R0mba-Na11avan/425_Function_Generator/Function_Generator_PCB/.pcb_assistant/memory.md

- config.h still OUTPUT_PEAK 10 V / 12 Vpp; user earlier said limit 5 V in sw - unresolved.
- AD9833 ds p.3: VOUT 38 mV-0.65 V typ; p.12 current DAC into on-chip 200R, R4 load scales whole wave. R4=10k -> Vc 0.337, 0.600 Vpp.
- (2026-11-13) User ADOPTED gain-stage values: R6/R19 2.00k, R10/R22 3.00k, R9/R21 1.00k; R5/R18 replaced by divider 3.3V->100R(+10uF)->3.83k->IN-, 576R IN-->GND (0.422 V, Rth 502). Square R3/R16 39.2k, R4/R17 10k (sq high level unverified). LTspice confirmed DC null with Vc 0.337.
- Suggested firmware residual-DC comp per waveform instead of trimpot (not done).
- Open schematic bugs: U5.1/U5.6 (U12 same) shorted on 10V_ref net -> add Ra 4.02k. Summer R13=Ra=R12=4.02k, R11=2.00k. +10V and +0.3V nets undriven. No sine RC LPF yet. -12V/3.3V decoupling missing.
- (2026-11-14) (2026-11-13) User buffered refs on U15 (OPA2810): U15A follower CENTER_BIAS from R25(3.3V)/R26 -> advised 68.1k/10.0k (0.4225 V) + 1uF on IN+; R5/R18 now plain 499. U15B follower +10V from R27(+12V)/R28 -> advised 20.0k/100k (10.0 V) + 1uF. AD5452 ds missing; VREF ±10 V from parts.md only.
- (2026-11-14) (2026-11-13) AD5452 ds now in library: VREF range ±10 V (p.3), VREF/RFB abs max ±12 V (p.6), VREF Rin 7-11k (p.3) -> +10V ref OK. Decoupling p.24: 0.1uF ceramic || 10uF per device at VDD pin. p.17: 1-2 pF C1 across RFB (pin8 to IOUT pin1) for high-speed I/V amp (OPA2810) - advised.
- (2026-11-14) Summer Ra FIXED: R29 (U5.1->10V_ref CH1), R30 (U12.1->FG_CH2/10V_ref). Value 4.02k advised; footprints unset.
- (2026-11-14) Summer final: Ra/R12/R13 & R30/R14/R20 = 4.02k, R11/R15 = 2.00k, all 0603 (R11 50 mW; 1k would be 100 mW).
- (2026-11-14) (2026-11-14) Sch now has: C17-20 100n + C23-26 10u on +3.3V; C21/C22 1.5p RFB caps on U8/U13 only (U9/U14 offset DACs none); 12x10n op-amp decoupling (matches OPA2810 ds p.36). SW3 TS5A23157 is a breakout module, no decap needed. Missing: bulk 2.2-6.8uF on -12V, C1/C2 values, footprints.
