R0mba-Na11avan/425_Function_Generator/Function_Generator_PCB/LTSpice_Simulation/20x_gain_test.asc

R1: res; 499
R2: res; 1k
R3: res; 2k
R4: res; 3k
U1: opamp
U2: opamp
V1: voltage; SINE(0.337 0.3 1k)
V2: voltage; 0.43
Named nets: 0, V_out, V_in, v_inter
.tran 0 10m 0
.lib opamp.sub
