R0mba-Na11avan/425_Function_Generator/Function_Generator_PCB/FG_CH1.kicad_sch

## KiCad design Function_Generator_PCB/FG_CH1.kicad_sch (2026-11-14, an earlier design)

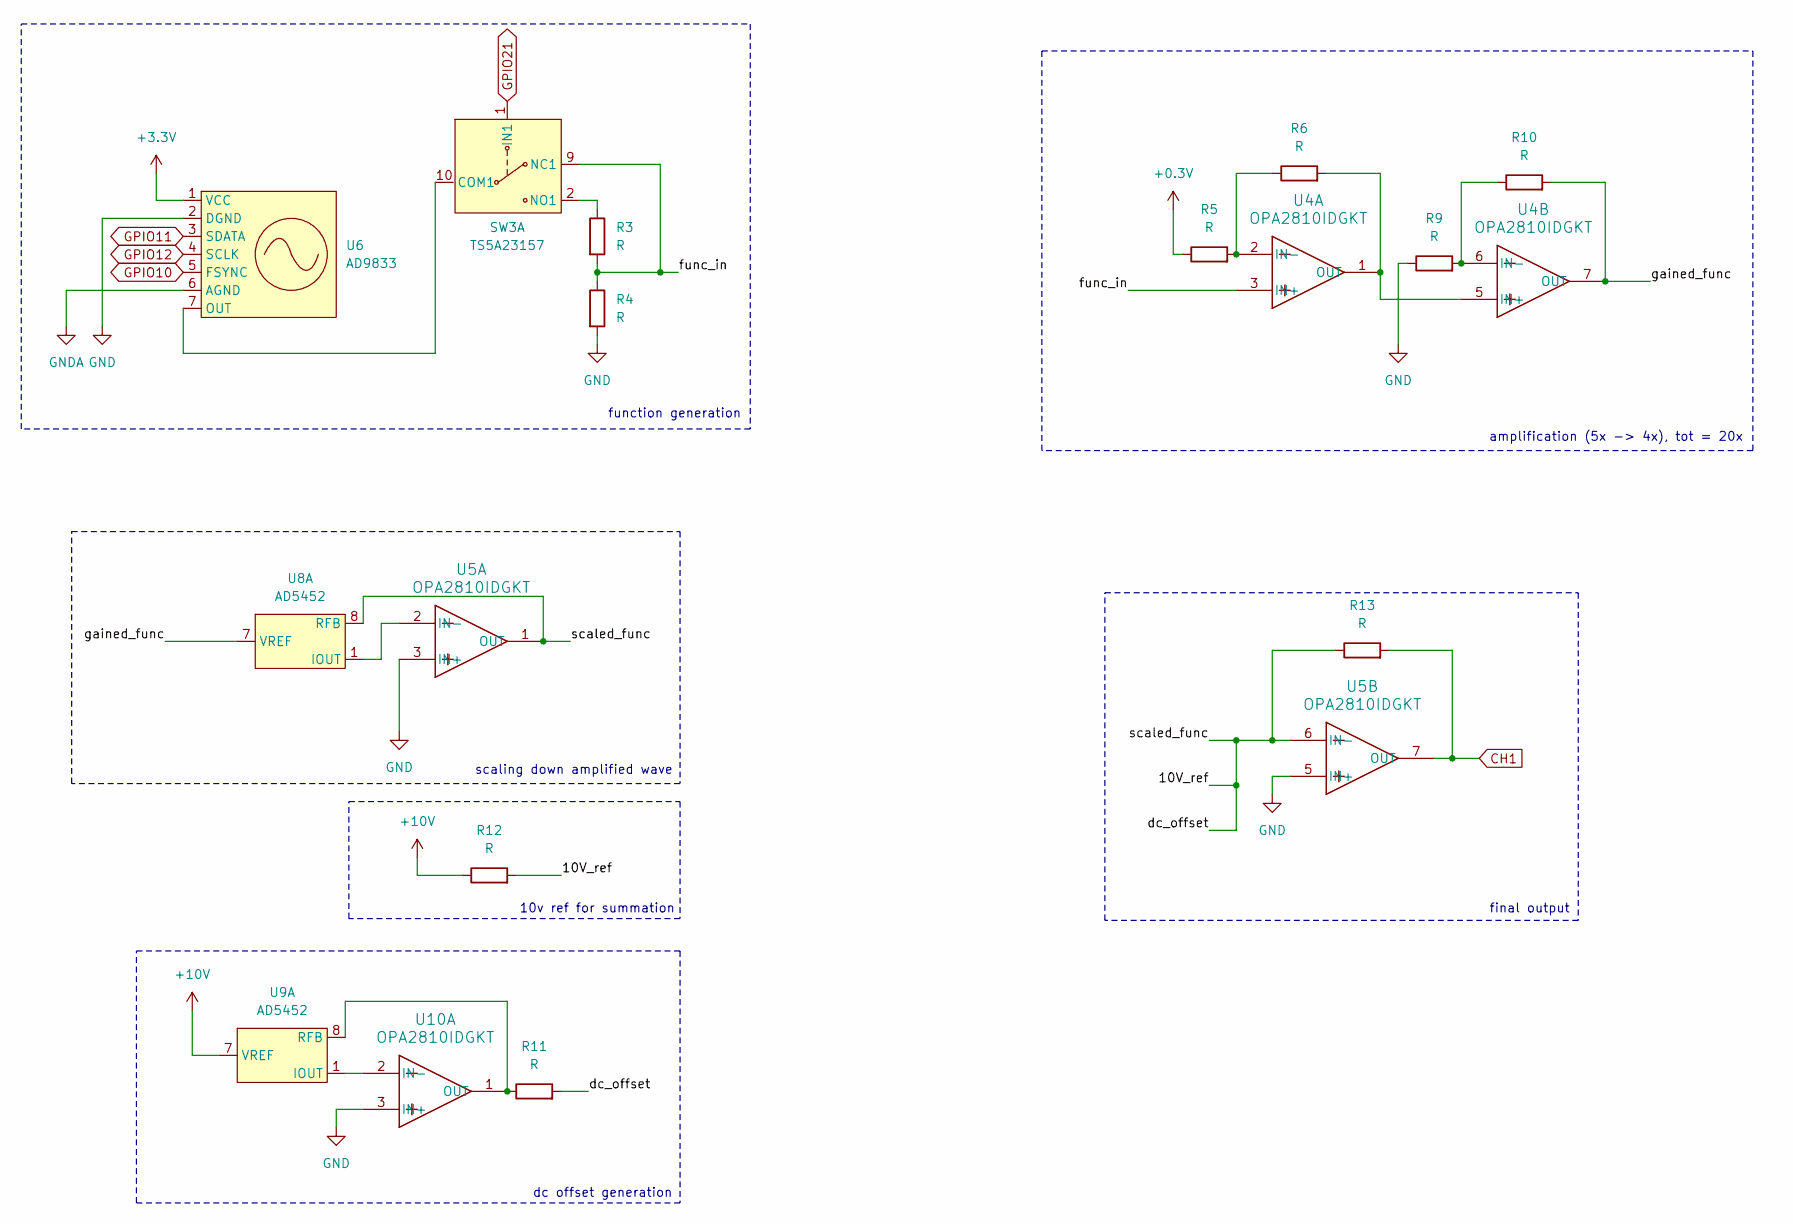
[picture p1: schematic FG_CH1.kicad_sch]

Parts:
R3, R4, R5, R6, R9, R10, R11, R12, R13: R
SW3: TS5A23157
U4, U5, U10: OPA2810IDGKT; DGK0008A_N
U6: AD9833
U8, U9: AD5452; RM_8_ADI-M

Connections:
10V_ref: R11.2, R12.2, R13.1, U5.1 (OUT), U5.6 (IN-), U8.8 (RFB)
+0.3V: R5.1
+3.3V: U6.1 (VCC)
+10V: R12.1, U9.7 (VREF)
CH1: R13.2, U5.7 (OUT)
GND: R4.2, R9.1, U5.3 (IN+), U5.5 (IN+), U6.2 (DGND), U10.3 (IN+)
GNDA: U6.6 (AGND)
GPIO10: U6.5 (FSYNC)
GPIO11: U6.3 (SDATA)
GPIO12: U6.4 (SCLK)
GPIO21: SW3.1 (IN1)
unnamed: R3.1, SW3.2 (NO1)
unnamed: R5.2, R6.1, U4.2 (IN-)
unnamed: R6.2, U4.1 (OUT), U4.5 (IN+)
unnamed: R9.2, R10.1, U4.6 (IN-)
unnamed: R11.1, U9.8 (RFB), U10.1 (OUT)
unnamed: SW3.10 (COM1), U6.7 (OUT)
unnamed: U5.2 (IN-), U8.1 (IOUT)
unnamed: U9.1 (IOUT), U10.2 (IN-)
func_in: R3.2, R4.1, SW3.9 (NC1), U4.3 (IN+)
gained_func: R10.2, U4.7 (OUT), U8.7 (VREF)

Notes on the sheet:
10v ref for summation
function generation
scaling down amplified wave
final output
amplification (5x -> 4x), tot = 20x
dc offset generation
