R0mba-Na11avan/425_Function_Generator/Function_Generator_PCB/FG_CH2.kicad_sch

## KiCad design Function_Generator_PCB/FG_CH2.kicad_sch (2026-11-14, an earlier design)

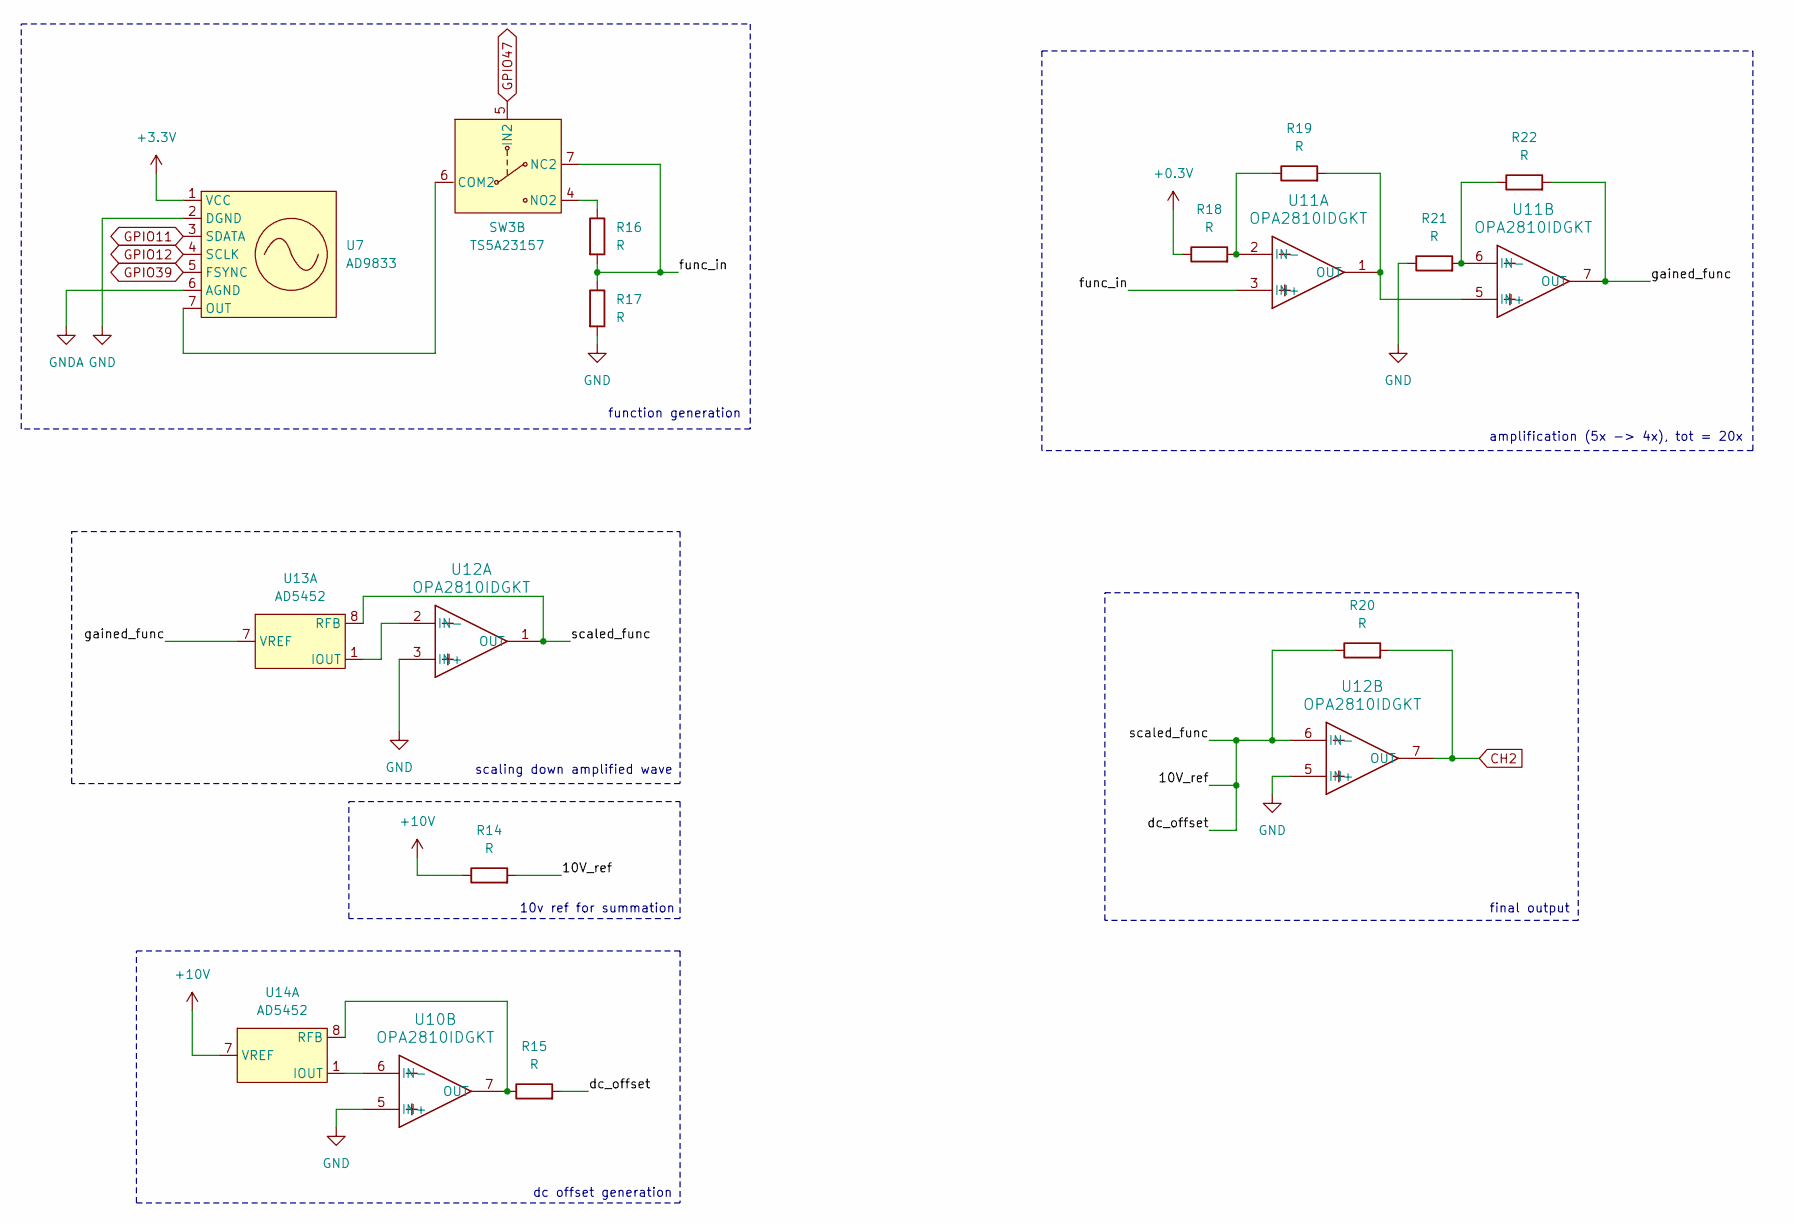
[picture p2: schematic FG_CH2.kicad_sch]

Parts:
R14, R15, R16, R17, R18, R19, R20, R21, R22: R
SW3: TS5A23157
U7: AD9833
U10, U11, U12: OPA2810IDGKT; DGK0008A_N
U13, U14: AD5452; RM_8_ADI-M

Connections:
10V_ref: R14.2, R15.2, R20.1, U12.1 (OUT), U12.6 (IN-), U13.8 (RFB)
+0.3V: R18.1
+3.3V: U7.1 (VCC)
+10V: R14.1, U14.7 (VREF)
CH2: R20.2, U12.7 (OUT)
GND: R17.2, R21.1, U7.2 (DGND), U10.5 (IN+), U12.3 (IN+), U12.5 (IN+)
GNDA: U7.6 (AGND)
GPIO11: U7.3 (SDATA)
GPIO12: U7.4 (SCLK)
GPIO39: U7.5 (FSYNC)
GPIO47: SW3.5 (IN2)
unnamed: R15.1, U10.7 (OUT), U14.8 (RFB)
unnamed: R16.1, SW3.4 (NO2)
unnamed: R18.2, R19.1, U11.2 (IN-)
unnamed: R19.2, U11.1 (OUT), U11.5 (IN+)
unnamed: R21.2, R22.1, U11.6 (IN-)
unnamed: SW3.6 (COM2), U7.7 (OUT)
unnamed: U10.6 (IN-), U14.1 (IOUT)
unnamed: U12.2 (IN-), U13.1 (IOUT)
func_in: R16.2, R17.1, SW3.7 (NC2), U11.3 (IN+)
gained_func: R22.2, U11.7 (OUT), U13.7 (VREF)

Notes on the sheet:
dc offset generation
10v ref for summation
amplification (5x -> 4x), tot = 20x
final output
function generation
scaling down amplified wave
