R0mba-Na11avan/425_Function_Generator/Function_Generator_PCB/Function-Generation.kicad_sch

## KiCad design Function_Generator_PCB/Function-Generation.kicad_sch (2026-11-14, an earlier design)

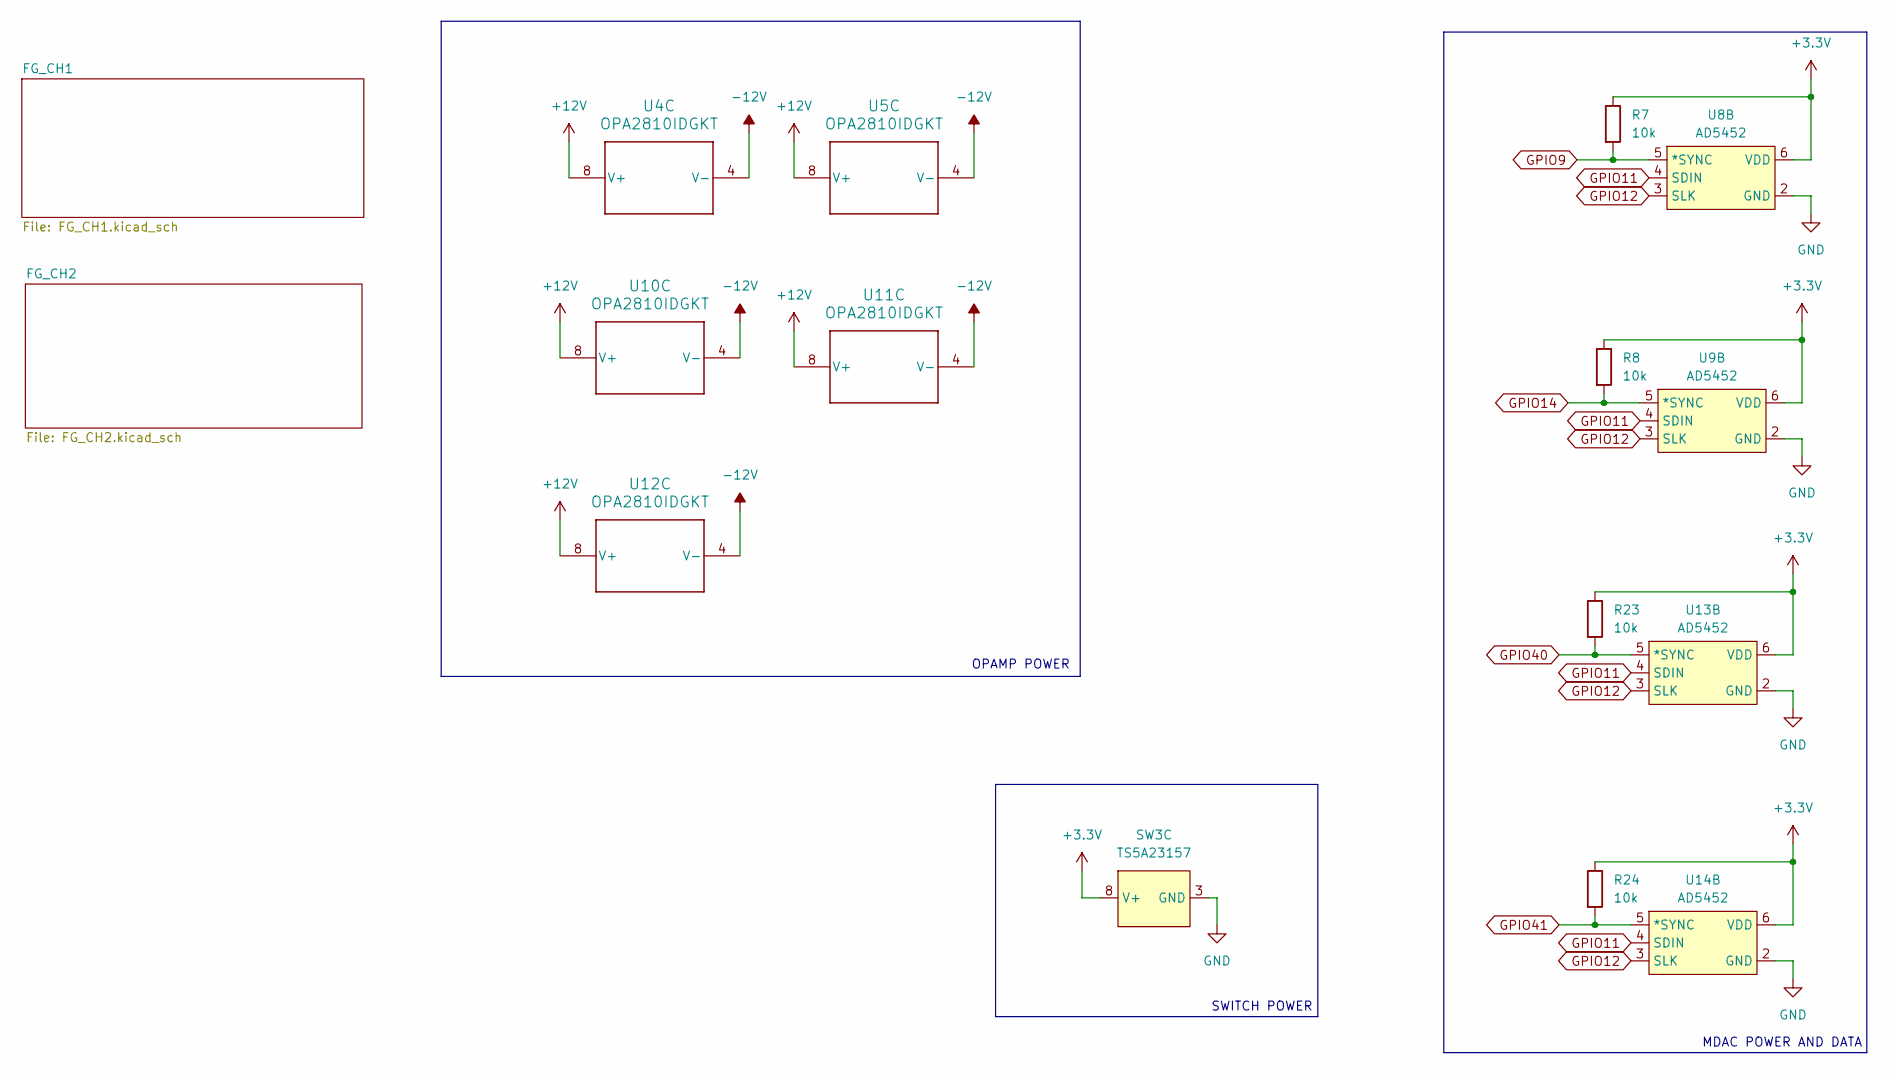
[picture p3: schematic Function-Generation.kicad_sch]

Parts:
R7, R8, R23, R24: 10k
SW3: TS5A23157
U4, U5, U10, U11, U12: OPA2810IDGKT; DGK0008A_N
U8, U9, U13, U14: AD5452; RM_8_ADI-M

Connections:
+3.3V: R7.1, R8.1, R23.1, R24.1, SW3.8 (V+), U8.6 (VDD), U9.6 (VDD), U13.6 (VDD), U14.6 (VDD)
+12V: U4.8 (V+), U5.8 (V+), U10.8 (V+), U11.8 (V+), U12.8 (V+)
-12V: U4.4 (V-), U5.4 (V-), U10.4 (V-), U11.4 (V-), U12.4 (V-)
GND: SW3.3 (GND), U8.2 (GND), U9.2 (GND), U13.2 (GND), U14.2 (GND)
GPIO9: R7.2, U8.5 (*SYNC)
GPIO11: U8.4 (SDIN), U9.4 (SDIN), U13.4 (SDIN), U14.4 (SDIN)
GPIO12: U8.3 (SLK), U9.3 (SLK), U13.3 (SLK), U14.3 (SLK)
GPIO14: R8.2, U9.5 (*SYNC)
GPIO40: R23.2, U13.5 (*SYNC)
GPIO41: R24.2, U14.5 (*SYNC)

Notes on the sheet:
OPAMP POWER
MDAC POWER AND DATA
SWITCH POWER
