R0mba-Na11avan/425_Function_Generator/Function_Generator_PCB/I-O.kicad_sch

## KiCad design Function_Generator_PCB/I-O.kicad_sch (2026-11-13, an earlier design)

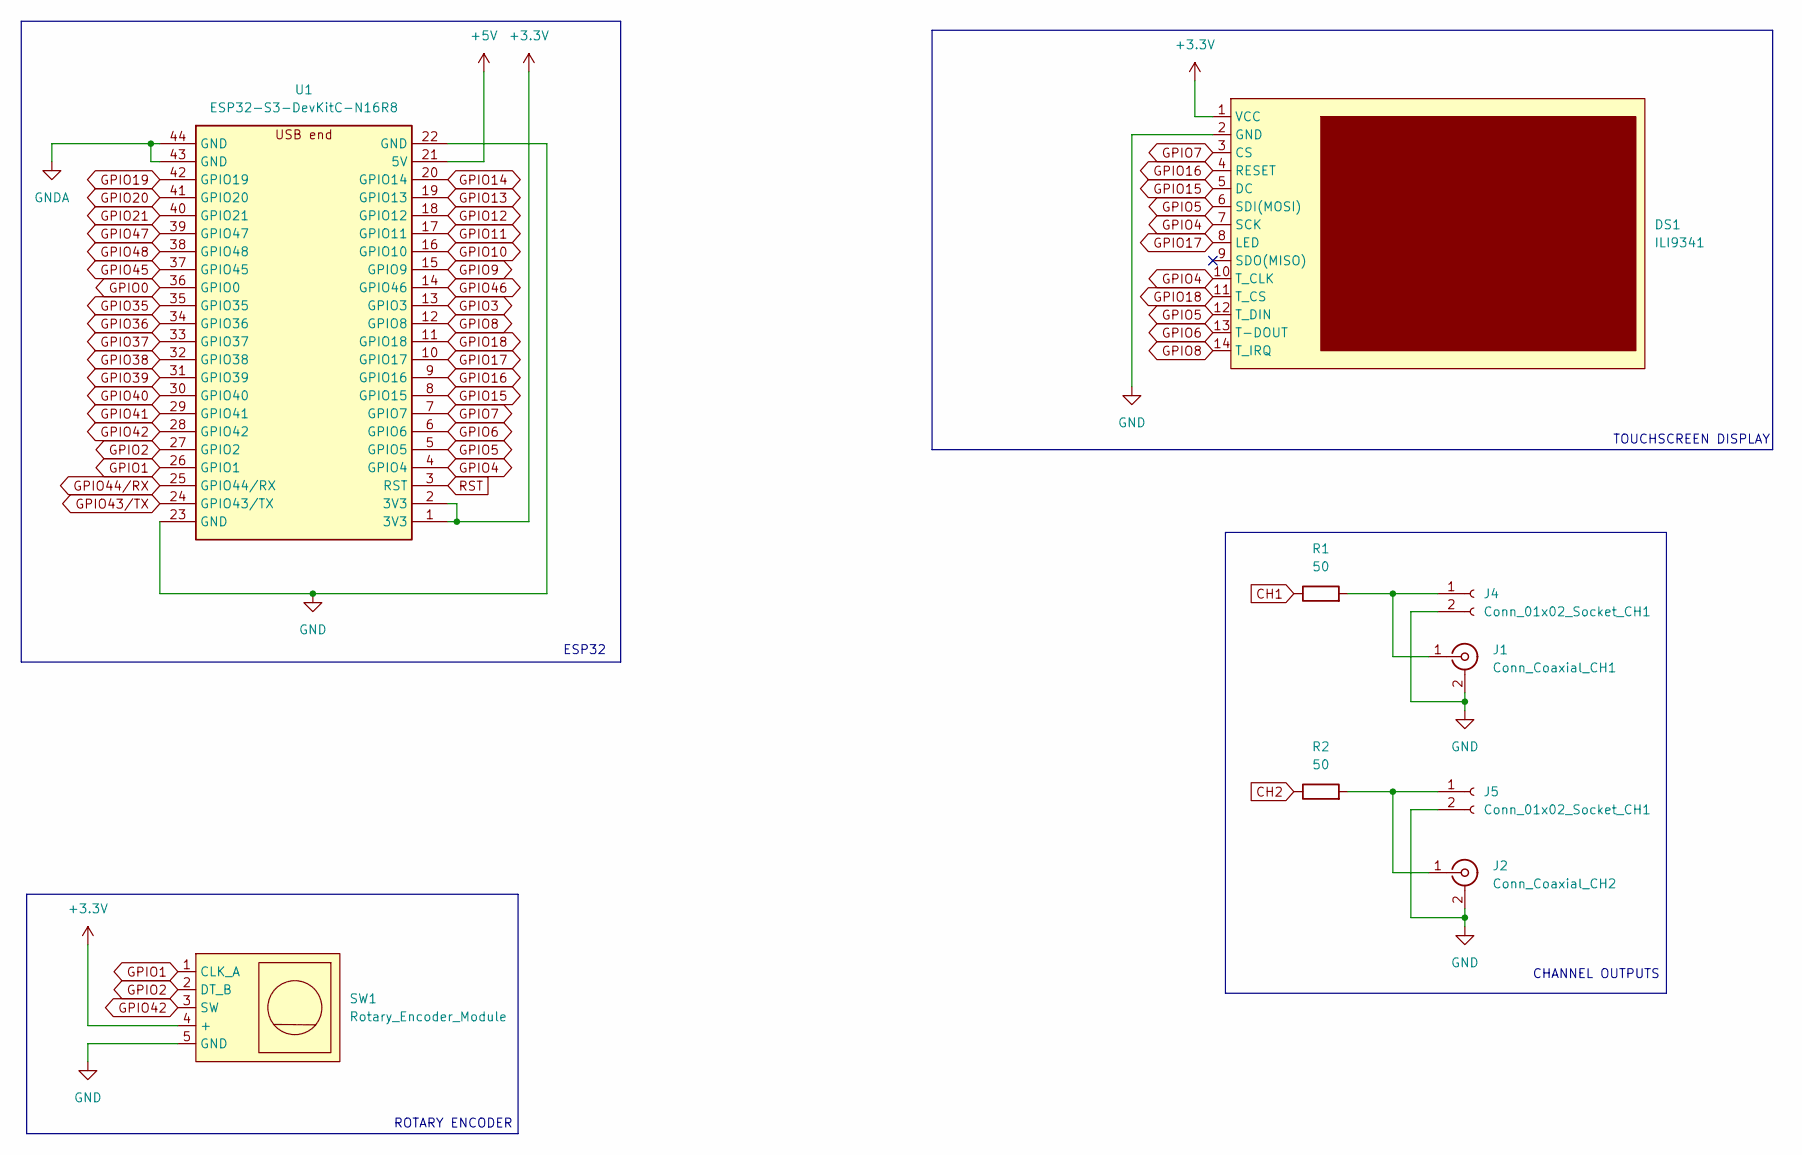
[picture p4: schematic I-O.kicad_sch]

Parts:
DS1: ILI9341
J1: Conn_Coaxial_CH1
J2: Conn_Coaxial_CH2
J4, J5: Conn_01x02_Socket_CH1
R1, R2: 50
SW1: Rotary_Encoder_Module; PinSocket_1x05_P2.54mm_Vertical
U1: ESP32-S3-DevKitC-N16R8; ESP32-S3-DevKitC-1_DualUSB

Connections:
+3.3V: DS1.1 (VCC), SW1.4 (+), U1.1 (3V3), U1.2 (3V3)
+5V: U1.21 (5V)
CH1: R1.1
CH2: R2.1
GND: DS1.2 (GND), J1.2 (Ext), J2.2 (Ext), J4.2, J5.2, SW1.5 (GND), U1.22 (GND), U1.23 (GND)
GNDA: U1.43 (GND), U1.44 (GND)
GPIO0: U1.36 (GPIO0)
GPIO1: SW1.1 (CLK_A), U1.26 (GPIO1)
GPIO2: SW1.2 (DT_B), U1.27 (GPIO2)
GPIO3: U1.13 (GPIO3)
GPIO4: DS1.7 (SCK), DS1.10 (T_CLK), U1.4 (GPIO4)
GPIO5: DS1.6 (SDI(MOSI)), DS1.12 (T_DIN), U1.5 (GPIO5)
GPIO6: DS1.13 (T-DOUT), U1.6 (GPIO6)
GPIO7: DS1.3 (CS), U1.7 (GPIO7)
GPIO8: DS1.14 (T_IRQ), U1.12 (GPIO8)
GPIO9: U1.15 (GPIO9)
GPIO10: U1.16 (GPIO10)
GPIO11: U1.17 (GPIO11)
GPIO12: U1.18 (GPIO12)
GPIO13: U1.19 (GPIO13)
GPIO14: U1.20 (GPIO14)
GPIO15: DS1.5 (DC), U1.8 (GPIO15)
GPIO16: DS1.4 (RESET), U1.9 (GPIO16)
GPIO17: DS1.8 (LED), U1.10 (GPIO17)
GPIO18: DS1.11 (T_CS), U1.11 (GPIO18)
GPIO19: U1.42 (GPIO19)
GPIO20: U1.41 (GPIO20)
GPIO21: U1.40 (GPIO21)
GPIO35: U1.35 (GPIO35)
GPIO36: U1.34 (GPIO36)
GPIO37: U1.33 (GPIO37)
GPIO38: U1.32 (GPIO38)
GPIO39: U1.31 (GPIO39)
GPIO40: U1.30 (GPIO40)
GPIO41: U1.29 (GPIO41)
GPIO42: SW1.3 (SW), U1.28 (GPIO42)
GPIO43/TX: U1.24 (GPIO43/TX)
GPIO44/RX: U1.25 (GPIO44/RX)
GPIO45: U1.37 (GPIO45)
GPIO46: U1.14 (GPIO46)
GPIO47: U1.39 (GPIO47)
GPIO48: U1.38 (GPIO48)
unnamed: J1.1 (In), J4.1, R1.2
unnamed: J2.1 (In), J5.1, R2.2
RST: U1.3 (RST)

Notes on the sheet:
CHANNEL OUTPUTS
ROTARY ENCODER
ESP32
TOUCHSCREEN DISPLAY
