R0mba-Na11avan/425_Function_Generator/Function_Generator_PCB/power.kicad_sch

## KiCad design Function_Generator_PCB/power.kicad_sch (2026-11-14, an earlier design)

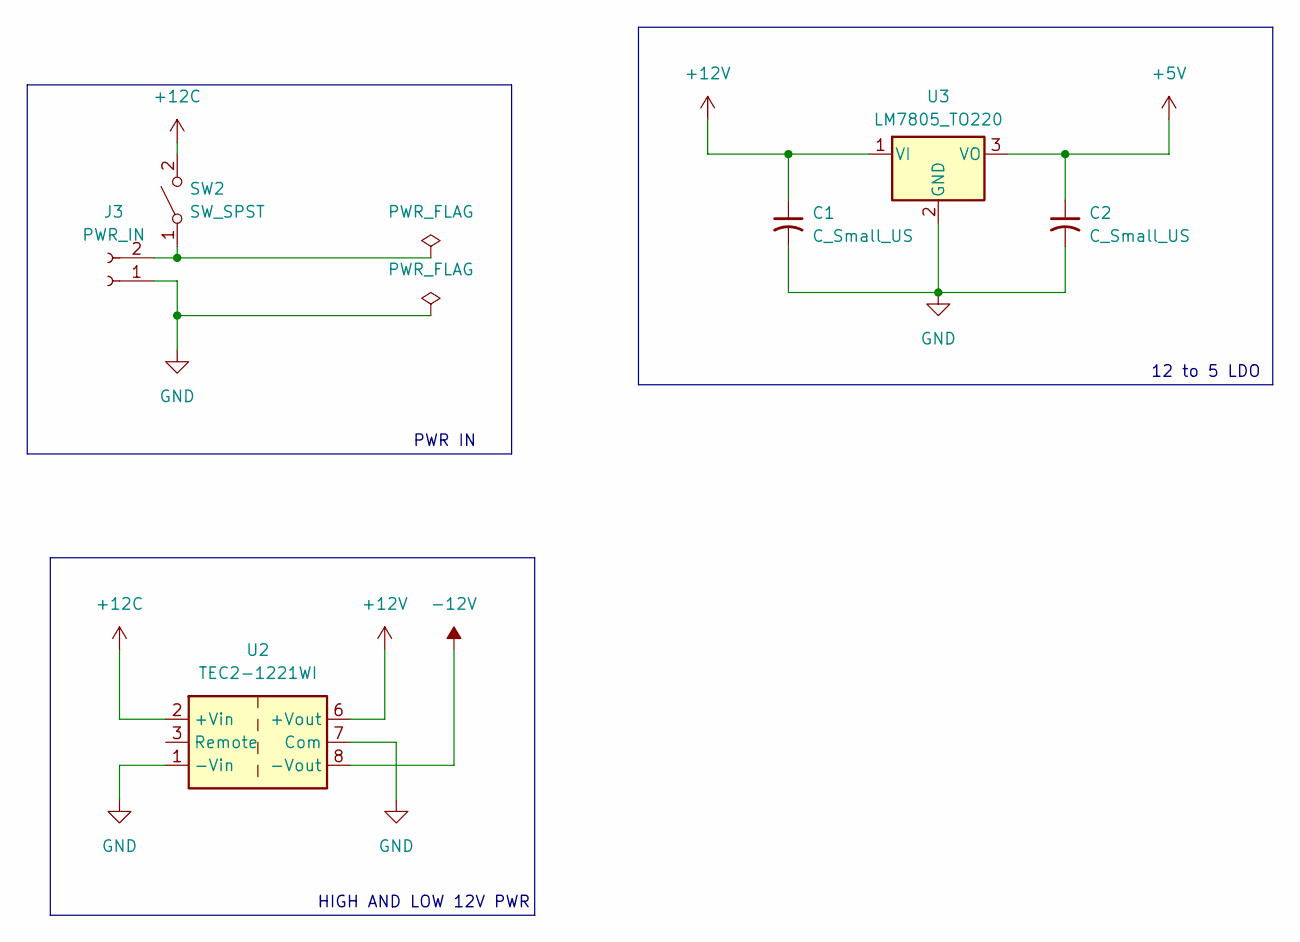
[picture p5: schematic power.kicad_sch]

Parts:
C1: C_Small_US; C_0805_2012Metric
C2: C_Small_US; CP_Radial_D6.3mm_P2.50mm
J3: PWR_IN; BarrelJack_CUI_PJ-102AH_Horizontal
SW2: SW_SPST; SW_PUSH-12mm_Wuerth-430476085716
U2: TEC2-1221WI; Converter_DCDC_TRACO_TEC2-12xxWI_24xxWI_48xxWI_THT
U3: LM7805_TO220; TO-220-3_Vertical

Connections:
+5V: C2.1, U3.3 (VO)
+12C: SW2.2 (B), U2.2 (+Vin)
+12V: C1.1, U2.6 (+Vout), U3.1 (VI)
-12V: U2.8 (-Vout)
GND: C1.2, C2.2, J3.1, U2.1 (-Vin), U2.7 (Com), U3.2 (GND)
unnamed: J3.2, SW2.1 (A)

Notes on the sheet:
12 to 5 LDO
PWR IN
HIGH AND LOW 12V PWR
