R0mba-Na11avan/425_Function_Generator/src/ui/dashboard_logic.cpp

#include "dashboard_logic.h"

#include <math.h>
#include <stdio.h>
#include <string.h>

//layout

static const Rect STATUS_RECT = {0, 0, LCD_WIDTH, 20};
static const Rect BLE_SLOT_RECT = {LCD_WIDTH - 20, 2, 16, 16};
static const Rect MCP_BADGE_RECT = {LCD_WIDTH - 56, 3, 32, 14};
static const Rect INFO_RECT = {0, 20, LCD_WIDTH, LCD_HEIGHT - 20};
static const Rect INFO_CLOSE_RECT = {LCD_WIDTH - 58, 24, 50, 18};
static const Rect INFO_BUTTON_RECTS[2] = {
    {10, 188, 145, 40},
    {165, 188, 145, 40}
};

static const Rect FIELD_RECTS[UI_FIELD_COUNT] = {
    {2, 22, 156, 70},       //WAVEFORM
    {162, 22, 156, 70},     //OUTPUT
    {2, 94, 316, 76},       //FREQUENCY
    {2, 172, 156, 66},      //AMPLITUDE
    {162, 172, 156, 66}     //OFFSET
};

//frequency field: unit column at the right, digits right aligned before it
static const int16_t FREQ_UNIT_W = 52;     //widest unit ("MHz") in FreeSansBold12
static const int16_t FREQ_MARGIN = 6;

Rect statusRect() {
    return STATUS_RECT;
}

Rect bleSlotRect() {
    return BLE_SLOT_RECT;
}

Rect mcpBadgeRect() {
    return MCP_BADGE_RECT;
}

Rect infoRect() {
    return INFO_RECT;
}

Rect infoCloseRect() {
    return INFO_CLOSE_RECT;
}

Rect infoButtonRect(uint8_t slot) {
    return INFO_BUTTON_RECTS[slot ? 1 : 0];
}

Rect fieldRect(UI_FIELD field) {
    return FIELD_RECTS[(uint8_t)field];
}

bool fieldAt(int16_t x, int16_t y, UI_FIELD& field) {
    for (uint8_t i = 0; i < UI_FIELD_COUNT; i++) {
        if (FIELD_RECTS[i].contains(x, y)) {
            field = (UI_FIELD)i;
            return true;
        }
    }
    return false;
}

//numbers

int16_t numCharWidth(char c) {
    //glyph widths of DigitalWF24pt7b (all digits share one cell, "1" sits at its right edge)
    if (c >= '0' && c <= '9') return 25;
    if (c == '.') return 4;
    if (c == '-') return 11;
    if (c == '+') return 12;
    return 25;
}

int16_t numTextWidth(const char* text) {
    int16_t w = 0;
    for (const char* p = text; *p; p++) {
        if (p != text) w += NUM_GAP;
        w += numCharWidth(*p);
    }
    return w;
}

int16_t numCharX(const char* text, int16_t startX, int8_t index) {
    int16_t cx = startX;
    for (int8_t i = 0; i < index && text[i]; i++) {
        cx += numCharWidth(text[i]) + NUM_GAP;
    }
    return cx;
}

int8_t numCharAt(const char* text, int16_t startX, int16_t x) {
    int16_t cx = startX;
    for (int8_t i = 0; text[i]; i++) {
        int16_t w = numCharWidth(text[i]);
        //each character owns half the gap on either side
        if (x >= cx - NUM_GAP / 2 && x < cx + w + NUM_GAP / 2) return i;
        cx += w + NUM_GAP;
    }
    return -1;
}

//frequency

FrequencyText formatFrequency(float hz) {
    FrequencyText f;
    //pick the unit from the rounded value so 999.96 Hz reads "1.000 kHz", not "1000.0 Hz"
    if (hz < 999.95f) {
        snprintf(f.text, sizeof(f.text), "%.1f", hz);
        f.unit = "Hz";
        f.unitScale = 1.0f;
    } else if (hz < 999999.95f) {
        //4 decimals, so the 0.1 Hz digit is on screen too
        snprintf(f.text, sizeof(f.text), "%.4f", hz / 1e3);
        f.unit = "kHz";
        f.unitScale = 1e3f;
    } else {
        snprintf(f.text, sizeof(f.text), "%.6f", hz / 1e6);
        f.unit = "MHz";
        f.unitScale = 1e6f;
    }
    return f;
}

int16_t freqUnitX() {
    return FIELD_RECTS[(uint8_t)UI_FIELD::FREQUENCY].w - FREQ_MARGIN - FREQ_UNIT_W;
}

int16_t freqTextStartX(const char* text) {
    return freqUnitX() - FREQ_MARGIN - numTextWidth(text);
}

float digitPlace(const char* text, int8_t index) {
    int len = (int)strlen(text);
    if (index < 0 || index >= len) return 0;
    if (text[index] < '0' || text[index] > '9') return 0;

    const char* dot = strchr(text, '.');
    int dotIndex = dot ? (int)(dot - text) : len;
    int power = (index < dotIndex) ? dotIndex - index - 1 : -(index - dotIndex);
    return powf(10.0f, (float)power);
}

int8_t stepDigitIndex(const FrequencyText& f, float stepHz) {
    for (int8_t i = 0; f.text[i]; i++) {
        float place = digitPlace(f.text, i) * f.unitScale;
        if (place > 0 && fabsf(place - stepHz) < stepHz * 0.01f) return i;
    }
    return -1;
}

float freqStepHz(uint8_t index) {
    static const float STEPS[FREQ_STEP_COUNT] = {0.1f, 1.0f, 10.0f, 100.0f, 1e3f, 1e4f, 1e5f, 1e6f};
    if (index >= FREQ_STEP_COUNT) index = FREQ_STEP_COUNT - 1;
    return STEPS[index];
}

float freqResolutionHz(float hz) {
    //same unit choice as formatFrequency: MHz shows 6 decimals (1 Hz), the rest 0.1 Hz
    return formatFrequency(hz).unitScale >= 1e6f ? 1.0f : 0.1f;
}

uint8_t freqStepShown(float hz, uint8_t index) {
    if (index >= FREQ_STEP_COUNT) index = FREQ_STEP_COUNT - 1;
    float res = freqResolutionHz(hz);
    while (index < FREQ_STEP_COUNT - 1 && freqStepHz(index) < res * 0.5f) index++;
    return index;
}

uint8_t nextFreqStep(float hz, uint8_t index) {
    uint8_t next = freqStepShown(hz, index) + 1;
    if (next >= FREQ_STEP_COUNT) next = 0;
    return freqStepShown(hz, next);
}

void formatFreqStep(uint8_t index, char* out, size_t len) {
    static const char* const LABELS[FREQ_STEP_COUNT] = {
        "0.1 Hz", "1 Hz", "10 Hz", "100 Hz", "1 kHz", "10 kHz", "100 kHz", "1 MHz"
    };
    if (index >= FREQ_STEP_COUNT) index = FREQ_STEP_COUNT - 1;
    snprintf(out, len, "%s", LABELS[index]);
}

//other readouts

void formatAmplitude(float vpp, char* out, size_t len) {
    snprintf(out, len, "%.2f", vpp);
}

void formatOffset(float volts, char* out, size_t len) {
    //avoid "-0.00" for tiny negative values
    if (fabsf(volts) < 0.005f) volts = 0.0f;
    snprintf(out, len, "%+.2f", volts);
}

const char* waveformName(WAVEFORM waveform) {
    switch (waveform) {
        case WAVEFORM::SINE: return "SINE";
        case WAVEFORM::SQUARE: return "SQUARE";
        case WAVEFORM::TRIANGLE: return "TRIANGLE";
        default: return "?";
    }
}

void formatNetLine(const NetStatus& net, char* out, size_t len) {
    switch (net.state) {
        case WIFI_STATE::CONNECTING:
            snprintf(out, len, "Connecting to %s...", net.ssid);
            break;
        case WIFI_STATE::CONNECTED:
            snprintf(out, len, "%s.local  %s", net.hostname, net.ip);
            break;
        case WIFI_STATE::AP_MODE:
            snprintf(out, len, "Setup: join %s  %s", net.ssid, net.ip);
            break;
        case WIFI_STATE::IDLE:
        default:
            snprintf(out, len, "Wi-Fi off");
            break;
    }
}

uint8_t formatInfoLines(const NetStatus& net, const BleStatus& ble, char lines[][INFO_LINE_LEN], uint8_t maxLines) {
    uint8_t n = 0;
    #define INFO_LINE(...) do { if (n < maxLines) snprintf(lines[n++], INFO_LINE_LEN, __VA_ARGS__); } while (0)

    switch (net.state) {
        case WIFI_STATE::CONNECTED:
            INFO_LINE("Connected to %s", net.ssid);
            INFO_LINE("IP address  %s", net.ip);
            INFO_LINE("MCP  http://%s.local/mcp", net.hostname);
            INFO_LINE("     http://%s/mcp", net.ip);
            break;
        case WIFI_STATE::CONNECTING:
            INFO_LINE("Connecting to %s...", net.ssid);
            INFO_LINE("Goes to setup mode if it can't join.");
            break;
        case WIFI_STATE::AP_MODE:
            INFO_LINE("Setup mode");
            INFO_LINE("1. Join the Wi-Fi %s", net.ssid);
            INFO_LINE("2. Open http://%s", net.ip);
            INFO_LINE("3. Pick your network and save");
            break;
        case WIFI_STATE::IDLE:
        default:
            INFO_LINE("Wi-Fi off");
            break;
    }
    if (ble.state == BLE_STATE::OFF) {
        INFO_LINE("Bluetooth off");
    } else {
        INFO_LINE("Bluetooth  %s", ble.name);
        INFO_LINE("Phones  %u connected, %u paired", ble.connected, ble.bonded);
    }
    INFO_LINE("Firmware %s", FIRMWARE_VERSION);
    #undef INFO_LINE
    return n;
}

InfoButtons infoButtons(const NetStatus& net, const BleStatus& ble) {
    InfoButtons b;
    if (net.state == WIFI_STATE::AP_MODE) b.wifi = net.savedSsid[0] ? WIFI_BUTTON::BACK_TO_SAVED : WIFI_BUTTON::NONE;
    else b.wifi = WIFI_BUTTON::CHANGE_NETWORK;
    b.phones = ble.state != BLE_STATE::OFF;
    return b;
}

void formatWifiButton(const NetStatus& net, WIFI_BUTTON button, char* out, size_t len) {
    //a long name is cut to the button's width when it is drawn (fitButtonLabel)
    switch (button) {
        case WIFI_BUTTON::CHANGE_NETWORK:
            snprintf(out, len, "Change Wi-Fi");
            break;
        case WIFI_BUTTON::BACK_TO_SAVED:
            snprintf(out, len, "Back to %s", net.savedSsid);
            break;
        case WIFI_BUTTON::NONE:
        default:
            if (len) out[0] = '\0';
            break;
    }
}

uint8_t changedFields(const FuncGenState& a, const FuncGenState& b) {
    uint8_t mask = 0;
    if (a.waveform != b.waveform) mask |= fieldBit(UI_FIELD::WAVEFORM);
    if (a.outputEnabled != b.outputEnabled) mask |= fieldBit(UI_FIELD::OUTPUT_ENABLE);
    if (a.frequency != b.frequency) mask |= fieldBit(UI_FIELD::FREQUENCY);
    if (a.amplitude != b.amplitude) mask |= fieldBit(UI_FIELD::AMPLITUDE);
    if (a.dcOffset != b.dcOffset) mask |= fieldBit(UI_FIELD::OFFSET);
    return mask;
}

//remote highlight

const char* remoteBadgeText(CHANGE_SOURCE source) {
    switch (source) {
        case CHANGE_SOURCE::BLE: return "BLE";
        case CHANGE_SOURCE::WEB: return "WEB";
        case CHANGE_SOURCE::MCP:
        default: return "MCP";
    }
}

void RemoteHighlight::changed(uint8_t fields, uint32_t nowMs, CHANGE_SOURCE source) {
    for (uint8_t i = 0; i < UI_FIELD_COUNT; i++) {
        if (fields & (1u << i)) _fieldAt[i] = nowMs;
    }
    _fields |= fields;
    _badgeAt = nowMs;
    _badge = true;
    _badgeSource = source;
}

uint8_t RemoteHighlight::flashing(uint32_t nowMs) const {
    uint8_t mask = 0;
    for (uint8_t i = 0; i < UI_FIELD_COUNT; i++) {
        if ((_fields & (1u << i)) && nowMs - _fieldAt[i] < UI_REMOTE_FLASH_MS) mask |= (uint8_t)(1u << i);
    }
    return mask;
}

bool RemoteHighlight::badge(uint32_t nowMs) const {
    return _badge && nowMs - _badgeAt < UI_REMOTE_BADGE_MS;
}

//pairing popup

void PairingPrompt::update(const BleStatus& ble, uint32_t nowMs) {
    if (ble.pairing == PAIRING::SHOW_PASSKEY && ble.pairingId != _id) {
        _id = ble.pairingId;
        _passkey = ble.passkey;
        _shown = PAIR_PROMPT::CODE;
        _sinceMs = nowMs;
        return;
    }

    switch (_shown) {
        case PAIR_PROMPT::CODE:
            if (ble.pairing == PAIRING::PAIRED || ble.pairing == PAIRING::FAILED) {
                _shown = ble.pairing == PAIRING::PAIRED ? PAIR_PROMPT::PAIRED : PAIR_PROMPT::FAILED;
                _sinceMs = nowMs;
            } else if (nowMs - _sinceMs >= BLE_PAIR_TIMEOUT_MS) {
                _cancel = true;
                _shown = PAIR_PROMPT::FAILED;
                _sinceMs = nowMs;
            }
            break;
        case PAIR_PROMPT::PAIRED:
        case PAIR_PROMPT::FAILED:
            if (nowMs - _sinceMs >= UI_PAIR_RESULT_MS) _shown = PAIR_PROMPT::HIDDEN;
            break;
        case PAIR_PROMPT::HIDDEN:
        default:
            break;
    }
}

bool PairingPrompt::handle(const InputEvent& event) {
    if (_shown == PAIR_PROMPT::HIDDEN) return false;
    if (event.type == INPUT_EVENT::ENCODER_DELTA) return true;
    if (_shown == PAIR_PROMPT::CODE) _cancel = true;
    _shown = PAIR_PROMPT::HIDDEN;
    return true;
}

bool PairingPrompt::takeCancel() {
    bool cancel = _cancel;
    _cancel = false;
    return cancel;
}

uint8_t PairingPrompt::secondsLeft(uint32_t nowMs) const {
    uint32_t elapsed = nowMs - _sinceMs;
    if (_shown != PAIR_PROMPT::CODE || elapsed >= BLE_PAIR_TIMEOUT_MS) return 0;
    return (uint8_t)((BLE_PAIR_TIMEOUT_MS - elapsed + 999) / 1000);
}

//editor

static float clampRange(float v, ValueRange r) {
    if (v < r.min) return r.min;
    if (v > r.max) return r.max;
    return v;
}

//steps v by delta * step, snapped to the step grid, clamped
static float stepSnapped(float v, int32_t delta, float step, ValueRange r) {
    float stepped = roundf((v + delta * step) / step) * step;
    return clampRange(stepped, r);
}

static EditCommand noCommand() {
    return EditCommand{EDIT_ACTION::NONE, WAVEFORM::SINE, 0.0f, false, DEVICE_ACTION::OPEN_WIFI_SETUP};
}

static EditCommand deviceCommand(DEVICE_ACTION action) {
    EditCommand c = noCommand();
    c.action = EDIT_ACTION::DEVICE;
    c.device = action;
    return c;
}

static bool itemAvailable(INFO_ITEM item, InfoButtons buttons) {
    switch (item) {
        case INFO_ITEM::WIFI: return buttons.wifi != WIFI_BUTTON::NONE;
        case INFO_ITEM::PHONES: return buttons.phones;
        case INFO_ITEM::CLOSE:
        default: return true;
    }
}

static EditCommand valueCommand(EDIT_ACTION action, float value, float current) {
    if (value == current) return noCommand();
    EditCommand c = noCommand();
    c.action = action;
    c.value = value;
    return c;
}

static EditCommand outputCommand(bool enabled) {
    EditCommand c = noCommand();
    c.action = EDIT_ACTION::SET_OUTPUT;
    c.enabled = enabled;
    return c;
}

DashboardEditor::DashboardEditor()
    : _selected(UI_FIELD::FREQUENCY), _editing(false), _stepIndex(UI_FREQ_STEP_DEFAULT), _infoOpen(false),
      _infoFocus(INFO_ITEM::CLOSE), _confirm(INFO_CONFIRM::NONE), _confirmOk(false), _lastInputMs(0) {}

EditCommand DashboardEditor::handle(const InputEvent& event, const FuncGenState& state, const FuncGenLimits& limits,
                                    uint32_t nowMs, InfoButtons buttons) {
    _lastInputMs = nowMs;

    if (_infoOpen) return onInfo(event, buttons);
    if (event.type == INPUT_EVENT::TOUCH_TAP && statusRect().contains(event.x, event.y)) {
        _infoOpen = true;
        _infoFocus = INFO_ITEM::CLOSE;
        _confirm = INFO_CONFIRM::NONE;
        _editing = false;
        return noCommand();
    }

    switch (event.type) {
        case INPUT_EVENT::ENCODER_DELTA: return onEncoder(event, state, limits);
        case INPUT_EVENT::BUTTON_SHORT: return onShortPress(state);
        case INPUT_EVENT::BUTTON_LONG: onLongPress(); return noCommand();
        case INPUT_EVENT::TOUCH_TAP: return onTap(event, state);
        default: return noCommand();
    }
}

INFO_ITEM DashboardEditor::infoFocus(InfoButtons buttons) const {
    return itemAvailable(_infoFocus, buttons) ? _infoFocus : INFO_ITEM::CLOSE;
}

EditCommand DashboardEditor::onInfo(const InputEvent& event, InfoButtons buttons) {
    if (_confirm != INFO_CONFIRM::NONE) return onConfirm(event);
    _infoFocus = infoFocus(buttons);

    switch (event.type) {
        case INPUT_EVENT::ENCODER_DELTA: {
            //step through the items that exist, wrapping around
            const uint8_t count = 3;
            int32_t steps = event.clicks;
            int32_t i = (int32_t)_infoFocus;
            while (steps != 0) {
                i = (i + (steps > 0 ? 1 : count - 1)) % count;
                if (itemAvailable((INFO_ITEM)i, buttons)) steps += steps > 0 ? -1 : 1;
            }
            _infoFocus = (INFO_ITEM)i;
            return noCommand();
        }
        case INPUT_EVENT::BUTTON_SHORT:
            return activate(_infoFocus, buttons);
        case INPUT_EVENT::BUTTON_LONG:
            _infoOpen = false;
            return noCommand();
        case INPUT_EVENT::TOUCH_TAP:
            if (buttons.wifi != WIFI_BUTTON::NONE && infoButtonRect(0).contains(event.x, event.y)) {
                return activate(INFO_ITEM::WIFI, buttons);
            }
            if (buttons.phones && infoButtonRect(1).contains(event.x, event.y)) {
                return activate(INFO_ITEM::PHONES, buttons);
            }
            _infoOpen = false;
            return noCommand();
        default:
            return noCommand();
    }
}

EditCommand DashboardEditor::activate(INFO_ITEM item, InfoButtons buttons) {
    _infoFocus = item;
    switch (item) {
        case INFO_ITEM::WIFI:
            if (buttons.wifi == WIFI_BUTTON::BACK_TO_SAVED) return deviceCommand(DEVICE_ACTION::LEAVE_WIFI_SETUP);
            _confirm = INFO_CONFIRM::OPEN_WIFI_SETUP;
            _confirmOk = false;
            return noCommand();
        case INFO_ITEM::PHONES:
            _confirm = INFO_CONFIRM::FORGET_PHONES;
            _confirmOk = false;
            return noCommand();
        case INFO_ITEM::CLOSE:
        default:
            _infoOpen = false;
            return noCommand();
    }
}

EditCommand DashboardEditor::onConfirm(const InputEvent& event) {
    bool ok = false;
    switch (event.type) {
        case INPUT_EVENT::ENCODER_DELTA:
            //Cancel on the left, OK on the right
            if (event.clicks != 0) _confirmOk = event.clicks > 0;
            return noCommand();
        case INPUT_EVENT::BUTTON_SHORT:
            ok = _confirmOk;
            break;
        case INPUT_EVENT::TOUCH_TAP:
            ok = infoButtonRect(1).contains(event.x, event.y);
            break;
        case INPUT_EVENT::BUTTON_LONG:
        default:
            break;
    }
    DEVICE_ACTION action = _confirm == INFO_CONFIRM::FORGET_PHONES ? DEVICE_ACTION::FORGET_PHONES
                                                                    : DEVICE_ACTION::OPEN_WIFI_SETUP;
    _confirm = INFO_CONFIRM::NONE;
    return ok ? deviceCommand(action) : noCommand();
}

void DashboardEditor::tick(uint32_t nowMs) {
    if (_editing && nowMs - _lastInputMs >= UI_EDIT_TIMEOUT_MS) _editing = false;
}

void DashboardEditor::remoteChanged(uint8_t fields) {
    //the agent's value wins, the next turn starts from it
    if (_editing && (fields & fieldBit(_selected))) _editing = false;
}

EditCommand DashboardEditor::onEncoder(const InputEvent& event, const FuncGenState& state, const FuncGenLimits& limits) {
    if (!_editing) {
        int32_t i = ((int32_t)_selected + event.clicks) % UI_FIELD_COUNT;
        if (i < 0) i += UI_FIELD_COUNT;
        _selected = (UI_FIELD)i;
        return noCommand();
    }

    switch (_selected) {
        case UI_FIELD::WAVEFORM: {
            int32_t i = ((int32_t)state.waveform + event.clicks) % WAVEFORM_COUNT;
            if (i < 0) i += WAVEFORM_COUNT;
            if ((WAVEFORM)i == state.waveform) return noCommand();
            EditCommand c = noCommand();
            c.action = EDIT_ACTION::SET_WAVEFORM;
            c.waveform = (WAVEFORM)i;
            return c;
        }
        case UI_FIELD::FREQUENCY: {
            //start from the value on screen (digits it hides are dropped, so
            //nothing invisible sticks around), then move by the step. the
            //other shown digits stay as they are, no snapping to the step
            double res = freqResolutionHz(state.frequency);
            double shown = round((double)state.frequency / res) * res;
            double hz = shown + (double)event.delta * freqStepHz(freqStepShown(state.frequency, _stepIndex));
            return valueCommand(EDIT_ACTION::SET_FREQUENCY, clampRange((float)hz, limits.frequency), state.frequency);
        }
        case UI_FIELD::AMPLITUDE: {
            //the offset stays put, so the knob stops at the peak limit
            ValueRange r = limits.amplitudeFor(state);
            return valueCommand(EDIT_ACTION::SET_AMPLITUDE,
                                stepSnapped(state.amplitude, event.delta, UI_AMP_STEP_V, r), state.amplitude);
        }
        case UI_FIELD::OFFSET:
            return valueCommand(EDIT_ACTION::SET_DC_OFFSET,
                                stepSnapped(state.dcOffset, event.delta, UI_OFFSET_STEP_V, limits.dcOffsetFor(state)),
                                state.dcOffset);
        case UI_FIELD::OUTPUT_ENABLE:
        default:
            return noCommand();
    }
}

EditCommand DashboardEditor::onShortPress(const FuncGenState& state) {
    if (_selected == UI_FIELD::OUTPUT_ENABLE) {
        _editing = false;
        return outputCommand(!state.outputEnabled);
    }
    if (_selected == UI_FIELD::FREQUENCY && _editing) {
        //while editing frequency a press picks the digit, a long press leaves
        _stepIndex = nextFreqStep(state.frequency, _stepIndex);
        return noCommand();
    }
    _editing = !_editing;
    return noCommand();
}

void DashboardEditor::onLongPress() {
    _editing = false;
}

EditCommand DashboardEditor::onTap(const InputEvent& event, const FuncGenState& state) {
    UI_FIELD field;
    if (!fieldAt(event.x, event.y, field)) return noCommand();

    if (field == UI_FIELD::OUTPUT_ENABLE) {
        _selected = field;
        _editing = false;
        return outputCommand(!state.outputEnabled);
    }

    if (field == UI_FIELD::FREQUENCY) {
        FrequencyText f = formatFrequency(state.frequency);
        Rect r = fieldRect(field);
        int8_t i = numCharAt(f.text, r.x + freqTextStartX(f.text), event.x);
        float placeHz = digitPlace(f.text, i) * f.unitScale;
        for (uint8_t s = 0; s < FREQ_STEP_COUNT; s++) {
            if (placeHz > 0 && fabsf(placeHz - freqStepHz(s)) < freqStepHz(s) * 0.01f) {
                _stepIndex = s;
                _selected = field;
                _editing = true;
                return noCommand();
            }
        }
    }

    if (field == _selected) {
        _editing = !_editing;
    } else {
        _selected = field;
        _editing = false;
    }
    return noCommand();
}
