R0mba-Na11avan/425_Function_Generator/(commit log)

2026-11-02 fixed a ton of variable and funciton name clashes
    [func_gen.h]
2026-11-07 added a ton of file comment stubs for implementation and added the arduinojson library
2026-11-07 small fixes and limits set , step 1
    [Arduino.h, SPI.h, chip_models.h, config.h, fakes.cpp, func_gen.h]
2026-11-07 can join wifi now and has a setup page. had to redo importing for arduino json, step 5
2026-11-12 started work on the schematic finally
    [Function-Generation.kicad_sch, Function_Generator_PCB.kicad_sch, I-O.kicad_sch, power.kicad_sch]
2026-11-13 Update KiCad project
    [power.kicad_sch]
2026-11-13 changed analog switch to TS5A23157
2026-11-13 tough draft of the function generator complete.
    [FG_CH1.kicad_sch, FG_CH2.kicad_sch, Function-Generation.kicad_sch, I-O.kicad_sch, power.kicad_sch]
2026-11-13 Update function generator schematics, PCB, and assistant data
    [FG_CH2.kicad_sch, Function-Generation.kicad_sch, Function_Generator_PCB.kicad_pcb, power.kicad_sch]
2026-11-13 Update function generator schematics and PCB assistant data
    [FG_CH1.kicad_sch, FG_CH2.kicad_sch, Function-Generation.kicad_sch, I-O.kicad_sch]
2026-11-14 added some final touches to the functiong enreate, added decoupling capcitors, and added the coltage references. also added a simulation for opamp gain
    [FG_CH1.kicad_sch, FG_CH2.kicad_sch, Function-Generation.kicad_sch, power.kicad_sch]
